YangRQ-2006/OTL-Bluetooth-Speaker/(list of files, drawings)

Other design files:
multisim/OTL-Bluetooth-Speaker.ms14
